codejupiter/rp2040-macropad/hardware/mechanical/step/mx_switch_proxy.step

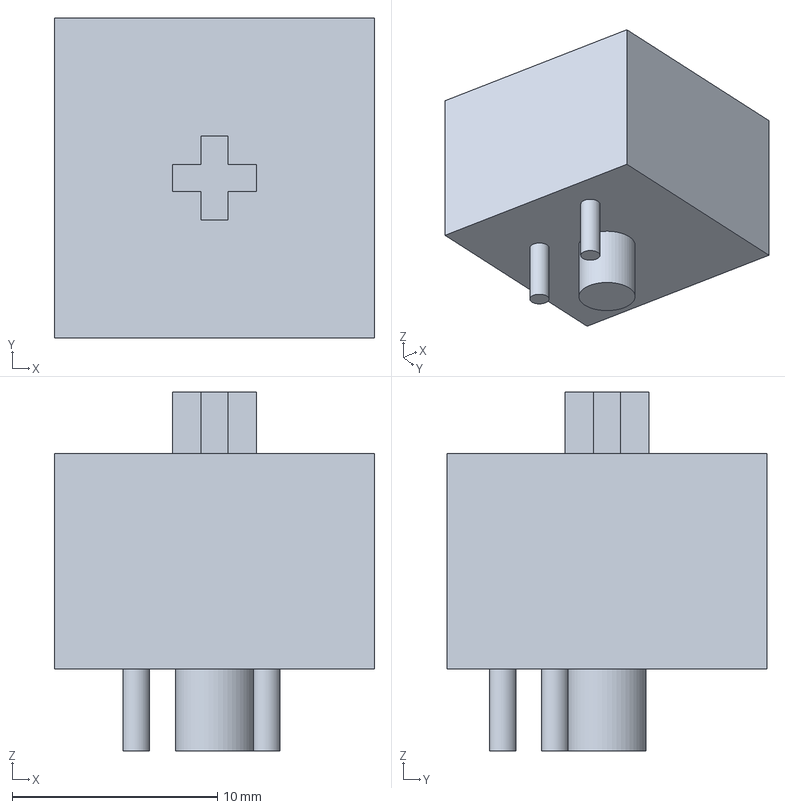
[picture p3: CAD file, 2026-11-01]
hardware/mechanical/step/mx_switch_proxy.step
15.6 x 15.6 x 17.5 mm
