codejupiter/rp2040-macropad/hardware/mechanical/step/bottom_enclosure.step

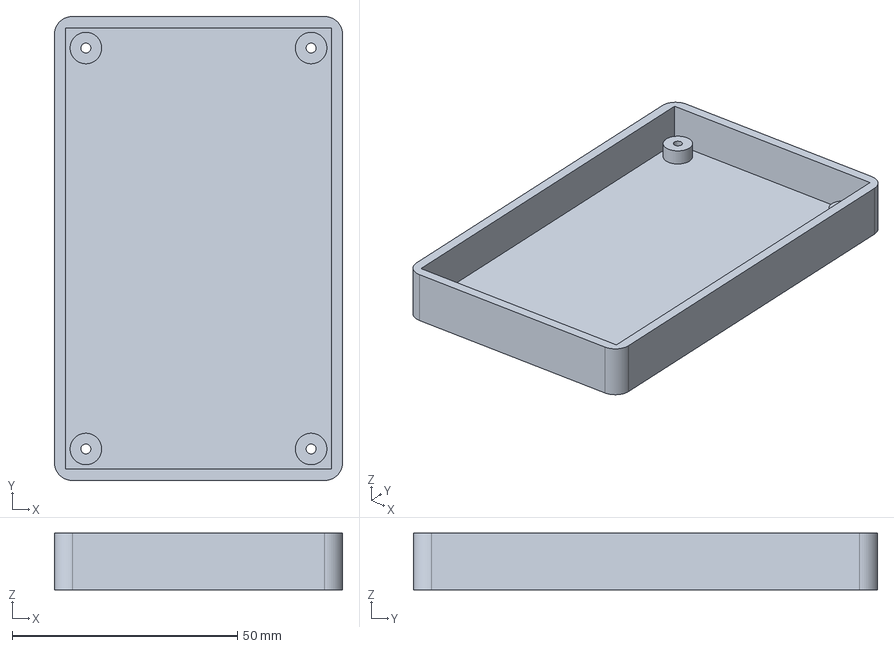
[picture p4: CAD file, 2026-11-01]
hardware/mechanical/step/bottom_enclosure.step
64.0 x 103.0 x 12.6 mm
