codejupiter/rp2040-macropad/hardware/mechanical/step/switch_plate.step

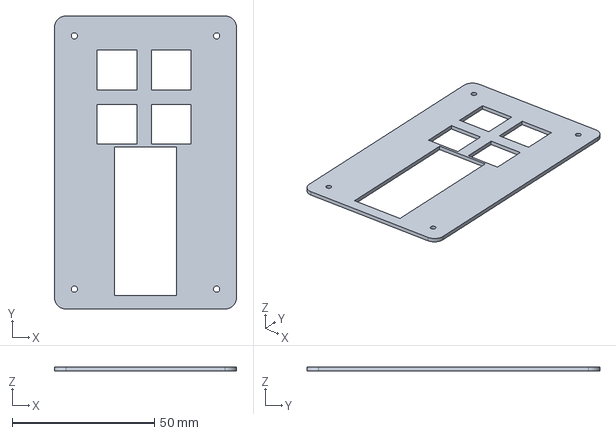
[picture p5: CAD file, 2026-11-01]
hardware/mechanical/step/switch_plate.step
64.0 x 103.0 x 1.50 mm
