codejupiter/rp2040-macropad/hardware/mechanical/step/diode_proxy.step

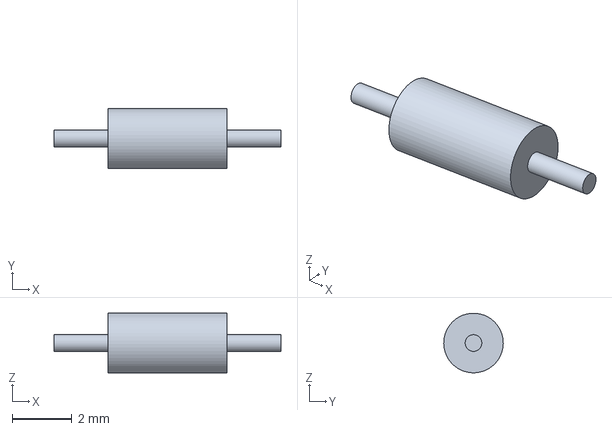
[picture p6: CAD file, 2026-11-01]
hardware/mechanical/step/diode_proxy.step
7.62 x 2.00 x 2.00 mm
