codejupiter/rp2040-macropad/hardware/mechanical/step/pico_proxy.step

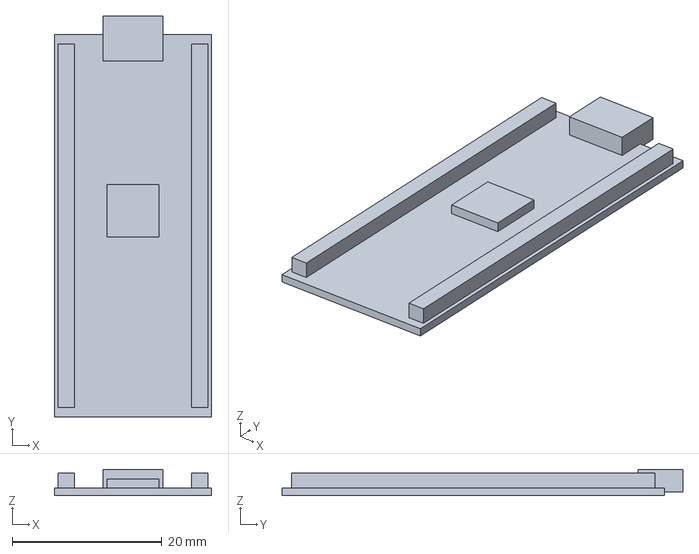
[picture p7: CAD file, 2026-11-01]
hardware/mechanical/step/pico_proxy.step
21.0 x 53.5 x 3.50 mm
