codejupiter/rp2040-macropad/hardware/mechanical/step/pcb_from_kicad.step

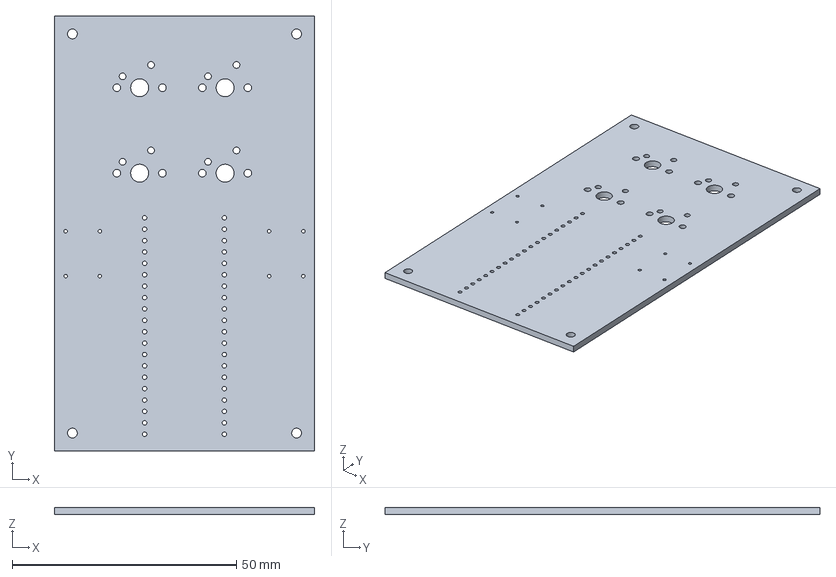
[picture p8: CAD file, 2026-11-01]
hardware/mechanical/step/pcb_from_kicad.step
58.0 x 97.0 x 1.60 mm
