codejupiter/rp2040-macropad/hardware/mechanical/step/keycap_proxy.step

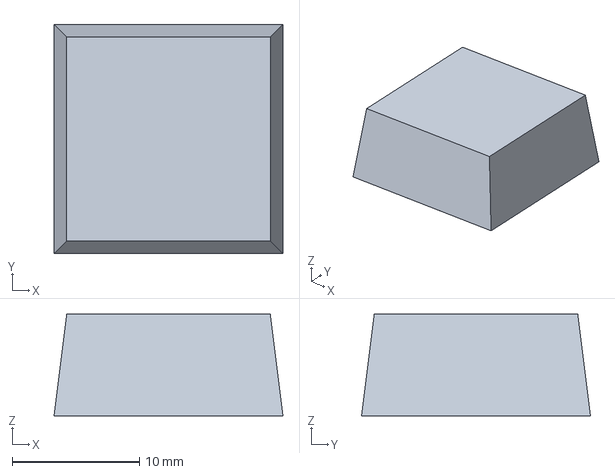
[picture p9: CAD file, 2026-11-01]
hardware/mechanical/step/keycap_proxy.step
18.0 x 18.0 x 8.00 mm
