codejupiter/rp2040-macropad/(list of files, cad)

Other CAD files:
hardware/mechanical/stl/bottom_enclosure.stl
hardware/mechanical/stl/diode_proxy.stl
hardware/mechanical/stl/keycap_proxy.stl
hardware/mechanical/stl/mx_switch_proxy.stl
hardware/mechanical/stl/pcb_from_kicad.stl
hardware/mechanical/stl/pico_proxy.stl
hardware/mechanical/stl/switch_plate.stl
