codejupiter/rp2040-macropad/hardware/MacroPad.kicad_pcb

## KiCad design hardware/MacroPad.kicad_pcb (2026-10-20)

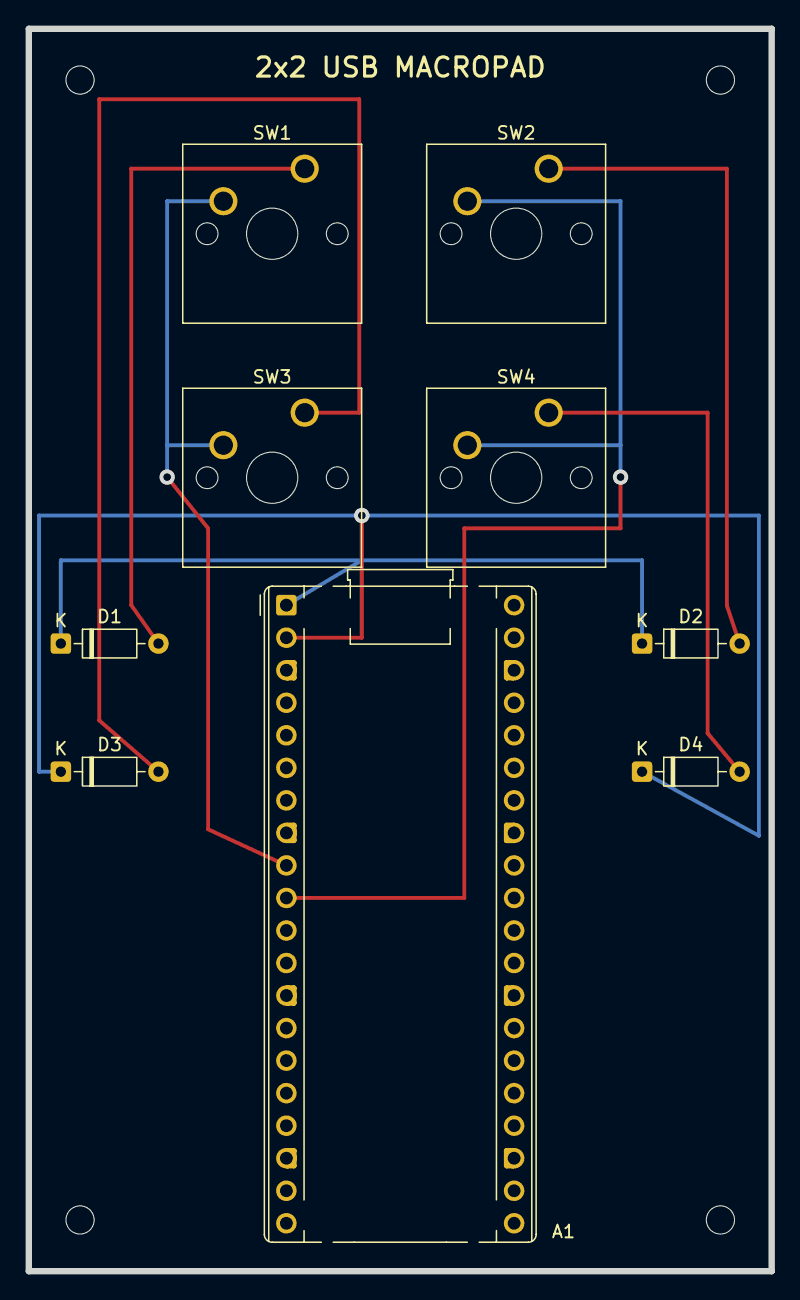
[picture p10: board MacroPad.kicad_pcb from above]

Board: 2 copper layers, 58.0 x 97.0 mm, 13 parts (0 on the bottom side), 8 nets.

Parts:
A1: RaspberryPi_Pico; RaspberryPi_Pico_Common_THT
D1, D2, D3, D4: 1N4148; D_DO-35_SOD27_P7.62mm_Horizontal
H1, H2, H3, H4: MountingHole_2.2mm_M2
SW1: K00; SW_Cherry_MX_1.00u_PCB
SW2: K01; SW_Cherry_MX_1.00u_PCB
SW3: K10; SW_Cherry_MX_1.00u_PCB
SW4: K11; SW_Cherry_MX_1.00u_PCB

Connections:
/COL0: A1.9 (GPIO6), SW1.2, SW3.2
/COL1: A1.10 (GPIO7), SW2.2, SW4.2
/ROW0: A1.1 (GPIO0), D1.1 (K), D2.1 (K)
/ROW1: A1.2 (GPIO1), D3.1 (K), D4.1 (K)
unnamed: D1.2 (A), SW1.1
unnamed: D2.2 (A), SW2.1
unnamed: D3.2 (A), SW3.1
unnamed: D4.2 (A), SW4.1
