codejupiter/rp2040-macropad/docs/ASSEMBLY.md

# Assembly and bring-up

## What you need

- One Raspberry Pi Pico (RP2040)
- Four MX-compatible switches and four keycaps
- Four 1N4148 through-hole diodes
- Two 1x20 male headers, plus sockets if you want a removable Pico
- Soldering iron, solder, flush cutters, and a multimeter
- A data-capable Micro-USB cable

## Assembly order

1. **Inspect the bare PCB.** Check for damaged plating, scratches across traces, or debris in the Pico and switch holes.
2. **Install D1–D4.** Bend each lead to 7.62 mm pitch. Match the diode's painted stripe to the PCB pad marked `K`; the stripe faces the associated row net.
3. **Solder the diodes.** Tack one lead, confirm the body is flat and polarity is correct, then solder the second lead and trim both.
4. **Install the Pico headers.** Use sockets on the macropad PCB if you want the Pico removable. Keep both rows square and parallel.
5. **Orient the Pico.** With the component side of the macropad PCB facing up and the four switches at the top, the Pico USB connector must point **up toward the switches** and the `USB Cable` silkscreen—not toward the `A1` marking at the bottom edge. Confirm pin 1/GP0 is aligned with footprint pad 1 before soldering. A Pico installed 180° backward can still enumerate over USB, but its GPIO pins will not match the matrix nets.
6. **Dry-fit the enclosure and plate.** Place the PCB on the four enclosure posts, align the plate's M2 holes, and confirm that the Pico and USB plug clear the large plate opening. Do not force a warped print over populated components.
7. **Install SW1–SW4 through the plate.** Snap each 1u MX switch into its 14 mm opening, lower the plate and switches onto the PCB, and inspect both switch pins from below. A folded pin can look seated from above while missing its plated hole.
8. **Solder the switches.** Confirm that every housing sits flat against the plate and that the plate remains parallel to the PCB, then solder both electrical pins per switch.
9. **Fasten the stack.** Use H1–H4 with M2 hardware of a verified length. Tighten in a diagonal pattern only until the printed plate is held flat.
10. **Install four 1u keycaps.** Press straight down while supporting the PCB/plate stack. No stabilizers are used because every key is 1u.

### Exploded mechanical reference

Exploded assembly animation

The layer order from bottom to top is enclosure → populated PCB → switch plate → four MX switches → four 1u keycaps. Cyan guide lines in the animation mark the four shared M2 axes. Download the [MP4 version](images/macropad-exploded-assembly.mp4) for higher-quality playback.

## Checks before power

With the board disconnected:

- Confirm there is no short between 3V3 and GND.
- Confirm no adjacent Pico header pads are bridged.
- Check each diode in diode-test mode; it should conduct in only one direction.
- Verify all four diode stripes align with the `K` silkscreen marks.
- Press each switch and check continuity through its switch/diode path.

## First flash

Build the firmware from the repository root, then run:

```bash
./flash_macropad.sh
```

If needed, hold **BOOTSEL** while connecting the Pico. After the script reports success, the board should enumerate as `RP2040 2x2 Macropad`.

Test SW1 through SW4 one at a time, allowing each launch sequence to finish:

| Key | Expected result |
| --- | --- |
| SW1 | KiCad opens through macOS Spotlight |
| SW2 | Chrome opens `https://vscode.dev` |
| SW3 | Chrome opens `https://github.com/codejupiter` |
| SW4 | The ChatGPT/Codex desktop app opens through macOS Spotlight |

The default firmware expects Spotlight to use Command+Space. Multiple presses are safe: the firmware queues them and runs each macro in grid order. The Pico's onboard LED flashes three times during startup and should remain on while any switch is held. If the startup flashes work but a key never lights the LED, troubleshoot the matrix before changing the host shortcut. If the wrong application opens, verify the corresponding Spotlight search manually and adjust the search text or delays in `main.cpp`.

## Troubleshooting

- **No USB device:** try a known data cable, inspect the Pico's USB connector, and re-enter BOOTSEL.
- **One dead key:** inspect that switch and its diode joints, then verify diode polarity.
- **A row or column is dead:** inspect the relevant Pico header pin and continuity to GP0, GP1, GP6, or GP7.
- **No onboard LED while pressing a key:** the matrix did not register the press; inspect switch pins, diode polarity, and the matching row/column connection.
- **Keys are swapped:** confirm the installed firmware uses the pin map and macro order in `main.cpp`.
- **Spotlight does not open:** enable the Command+Space Spotlight shortcut in macOS System Settings → Keyboard → Keyboard Shortcuts.
- **A launch sequence types into the wrong window:** increase that macro's launch delay in `main.cpp`, rebuild, and reflash.
- **A key repeats or chatters:** reflow its joints, test the switch, or increase `kDebounceMs`.
