codejupiter/rp2040-macropad/(commit log)

2026-10-20 feat: publish complete macropad project
    [BOM.csv, MacroPad.kicad_pcb, MacroPad.kicad_sch]
2026-11-01 feat: add parametric enclosure and exploded assembly animation
    [bottom_enclosure.step, bottom_enclosure.stl, diode_proxy.step, diode_proxy.stl, keycap_proxy.step, keycap_proxy.stl, mx_switch_proxy.step, mx_switch_proxy.stl]
2026-11-01 fix: align launcher macros with installed macOS apps
    [main.cpp]
2026-11-01 chore: add startup and matrix LED diagnostics
2026-11-01 docs: correct Pico mounting orientation
